Creative-Motion-Control-Course/Team-Cook/index.md

---
layout: default
title: Home
---

# [Team Cook] — Creative Motion Control Course Site

## Team Members

<div style="display: flex; flex-wrap: wrap; gap: 2em; margin-bottom: 2em;">

<div style="text-align: center; max-width: 200px;">
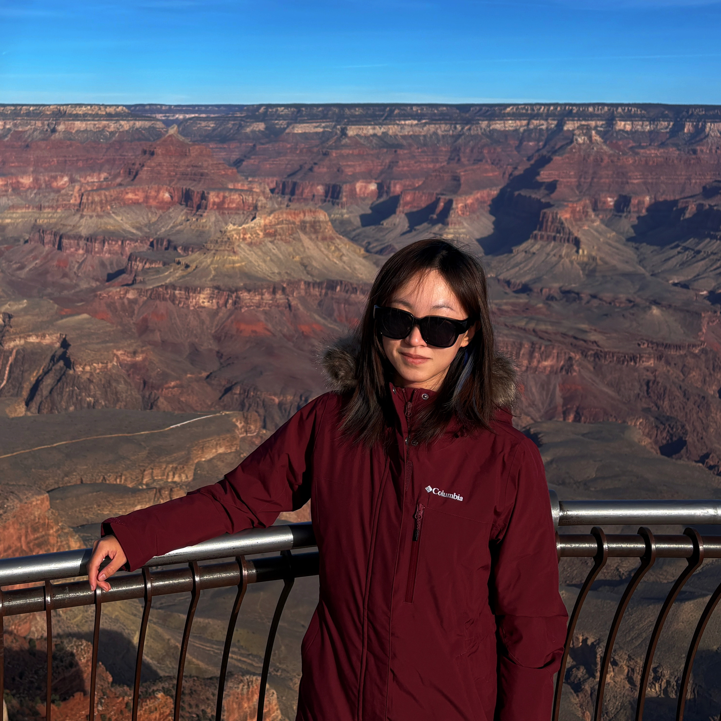
[picture p1: assets/jintongyang.JPG]
Member 1 photo
  
  <h3>Jintong Yang</h3>
  <p><em>PhD, Media Arts and Technology</em></p>
  <p>Hi! Before joining the program, I completed an MFA in Computer Arts and worked as a motion designer and technical artist in NYC. I am interested in digital fabrication, XR, and interaction design. I am excited to explore digital fabrication workflows, how to control and personalize my own CNC machine end-to-end, and how to combine it with visuals such as motion graphics and real-time interactions.</p>
</div>

<div style="text-align: center; max-width: 200px;">
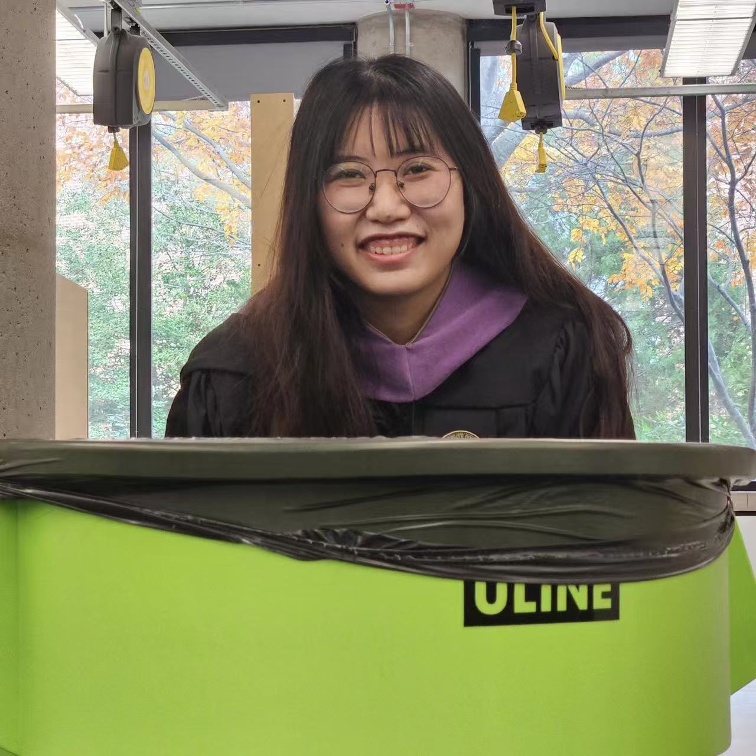
[picture p2: assets/Zhifan.jpg]
Member 2 photo
  
  <h3>Zhifan Guo</h3>
  <p><em>PhD, Media Arts and Technology</em></p>
  <p>Hi there! I am Zhifan, a first-year PhD student in MAT. With a background in industrial design, I enjoys crafting poetic and delightful connections with the physical world. I am passionate to explore how computational tools could augment our curiosity, creativity, and sustainable practices in interaction with tangible artifacts.</p>
</div>

<!-- Copy the block above to add more team members -->

</div>

## Projects

| Project | Description |
|---|---|
| [Project 1: Proposal](projects/project1/docs/proposal-project-1.md) | *An interactive CNC plotter system* |
| [Project 1: Interactive Moiré Pattern Plotter](projects/project1/docs/index.md) | *An interactive CNC plotter system* |
| [Final Project: Proposal](projects/final-project/docs/proposal-final-project.md) | *An interface for paper embroidery* |
| [Final Project: Mid-point](projects/final-project/docs/mid-point-final-project.md) | *An interface for paper embroidery* |
| [Final Project: Final Documentation](projects/final-project/docs/final-documentation-final-project.md)| *An interface for paper embroidery* |

<!-- Add rows as you complete more projects:
| [Project 2](projects/project2/docs/) | *Brief description of project 2* |
| [Project 3](projects/project3/docs/) | *Brief description of project 3* |
-->
