Creative-Motion-Control-Course/Team-Cook/(commit log)

2026-04-21 Arduino code for project 1
    Updated project description and added detailed serial commands for pattern drawing.
2026-06-09 0608 code for driver module
2026-06-23 Revise final documentation for workspace and pantograph
    Updated the final project documentation with details on workspace assembly and pantograph iterations.
