Creative-Motion-Control-Course/Team-Cook/projects/final-project/docs/assets/mapping_diagram.jpg

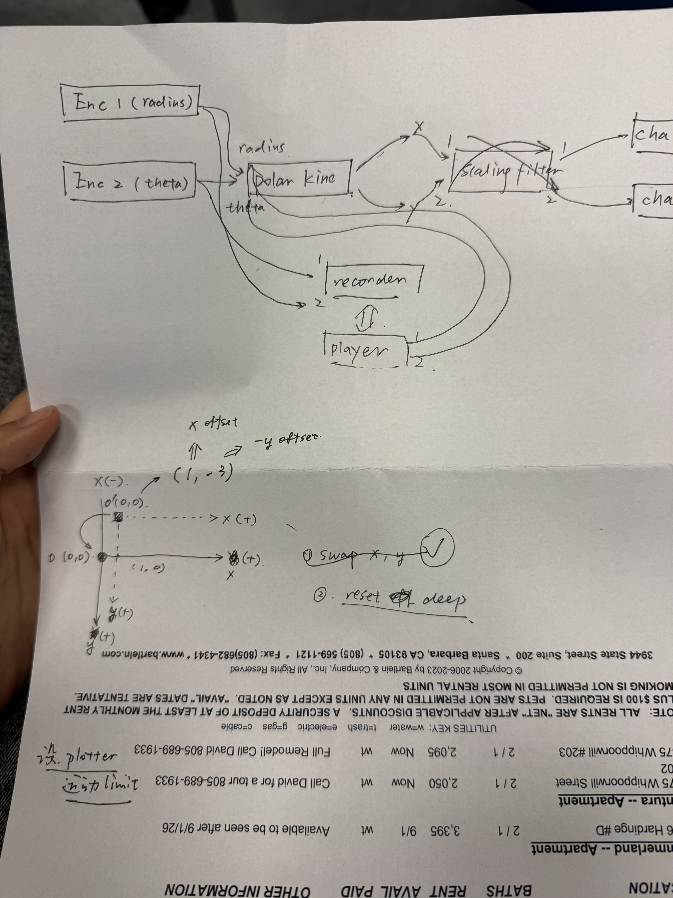
[picture p15: projects/final-project/docs/assets/mapping_diagram.jpg]
projects/final-project/docs/assets/mapping_diagram.jpg
